seife/marble_fx/doc/README.md

# How I modified my MarbleFX
I used a CJMCU Beetle board, because the integrated USB plug makes it very easy to solder the USB cable due to the large pin spacing.

## This is the MarbleFX before modification:
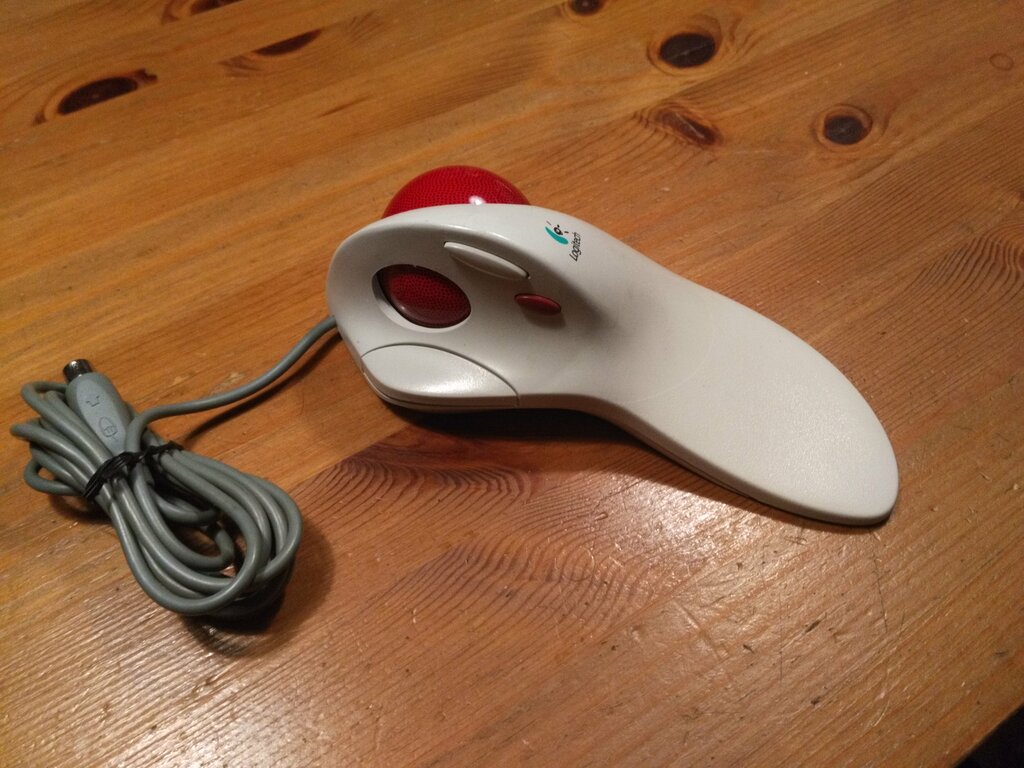
[picture p1: doc/01-marble_fx-original.jpg]
The unmodified MarbleFX


## The bottom opened and the interface PCB removed:
(beware, there's a screw hidden below the label sticker)
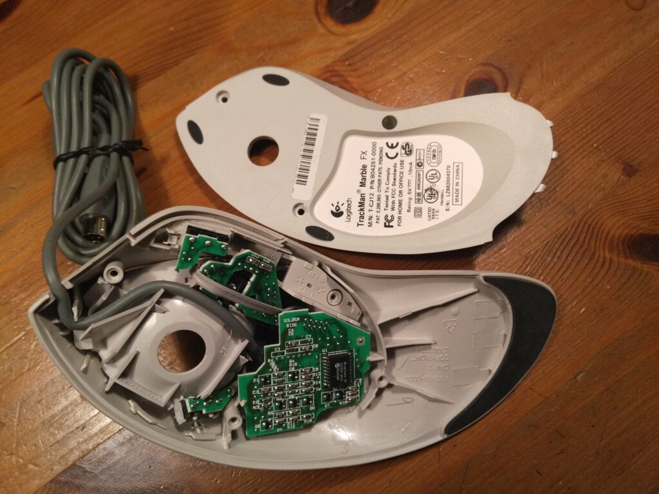
[picture p2: doc/02-marble_fx-open1.jpg]
Bottom opened

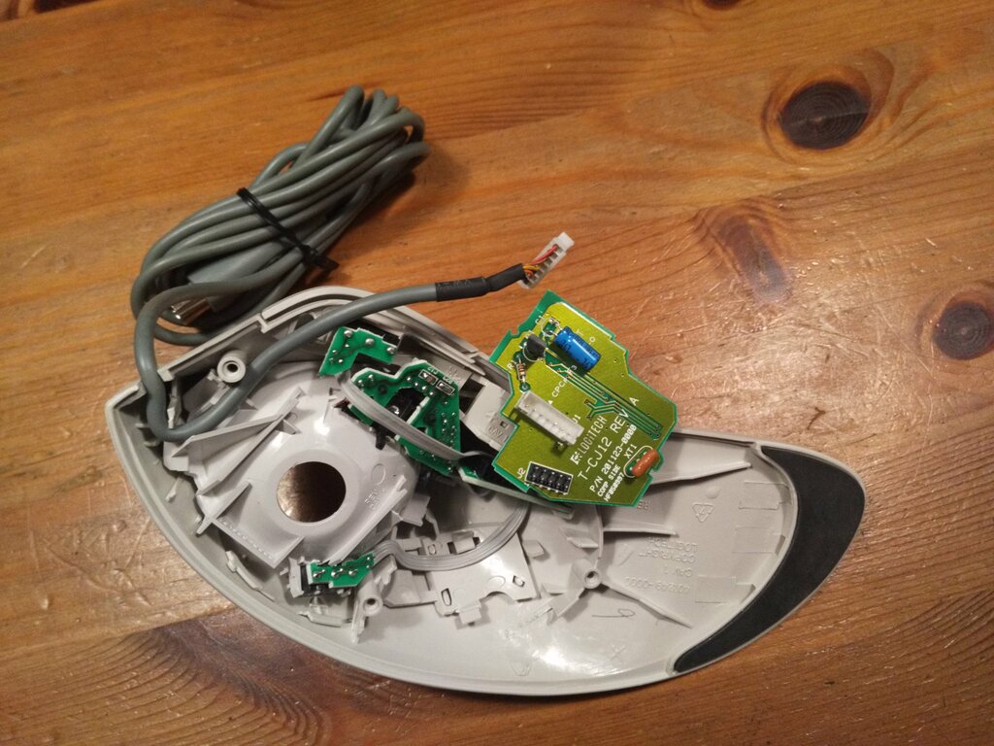
[picture p3: doc/03-marble_fx-open2.jpg]
PCB removed


## Close ups of the removed daughter PCB
(you need to solder the pins from the leonardo board to this board)
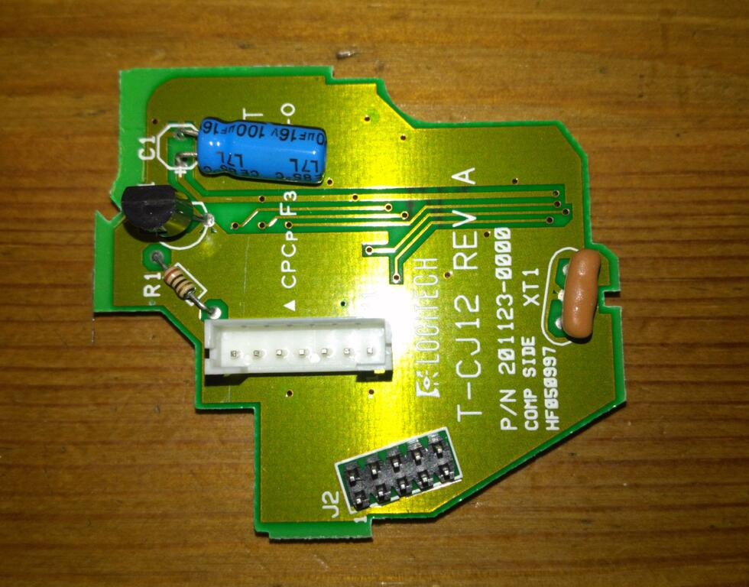
[picture p4: doc/04-marble_fx-pcb1.jpg]
PCB closeup 1

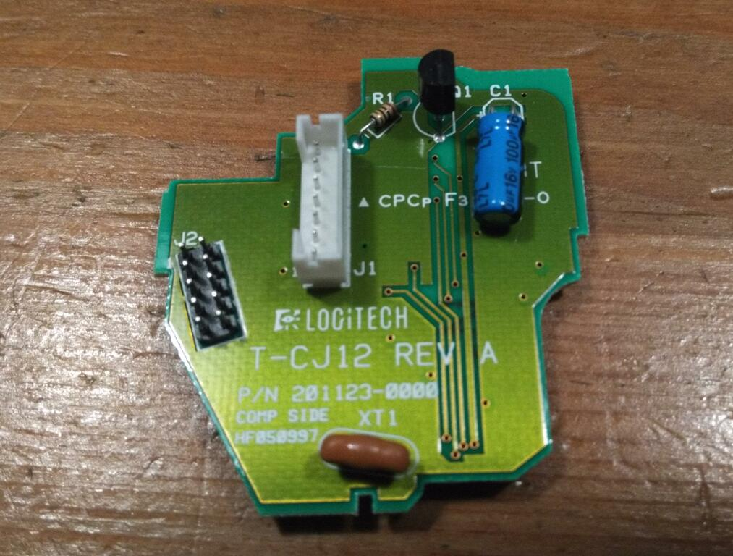
[picture p5: doc/05-marble_fx-pcb2.jpg]
PCB closeup 2


## Soldered the cables (USB and to the MarbleFX PCB) to the beetle
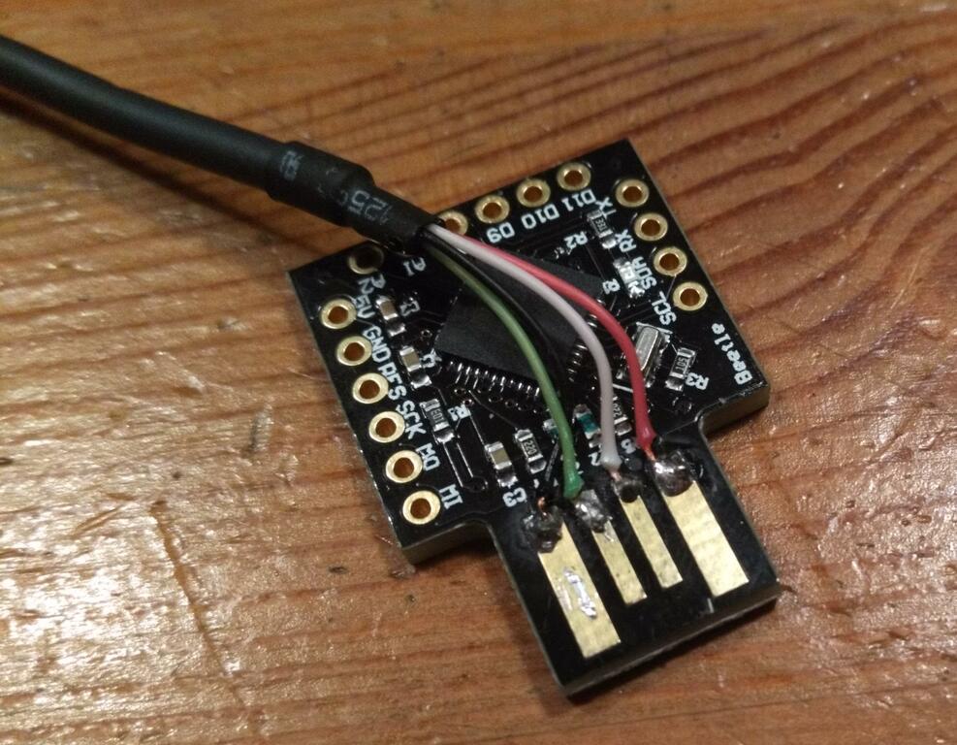
[picture p6: doc/06-marble_fx-beetle1.jpg]
Beetle USB cable

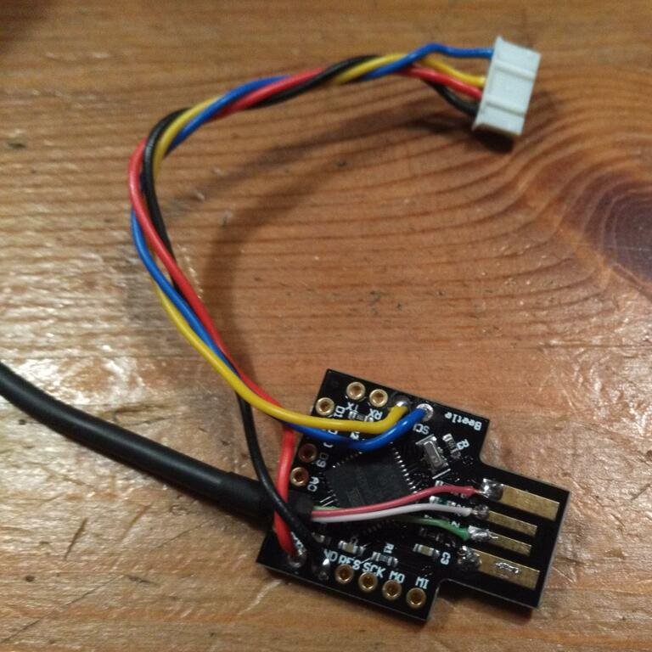
[picture p7: doc/07-marble_fx-beetle2.jpg]
Beetle USB+PCB cable


## Now connect it to the daughter PCB
I used a connector from a Logitech USB mouse cable, so that I did not need to cut the original PS/2 cable. So everything can be returned to the original state.
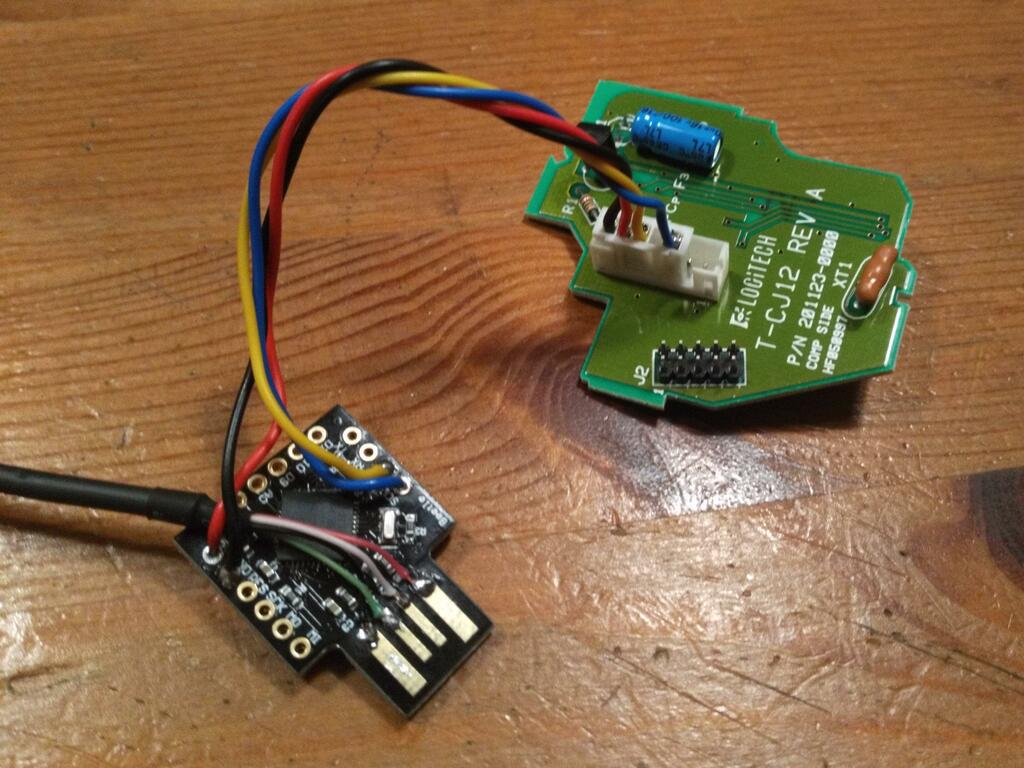
[picture p8: doc/08-marble_fx-beetle-pcb1.jpg]
Beetle + PCB1

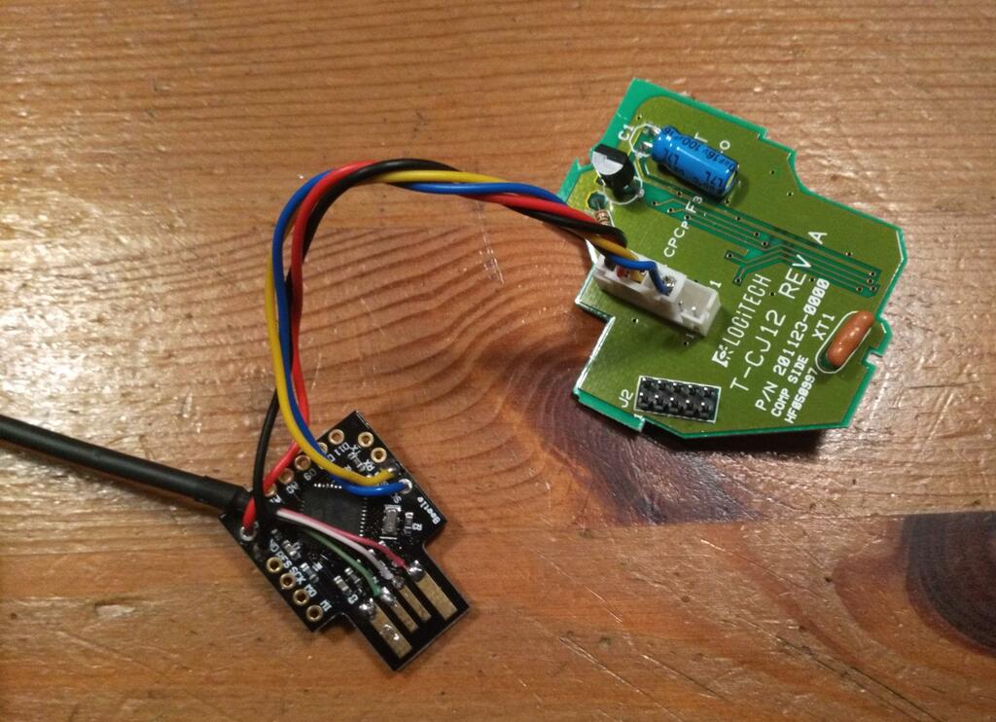
[picture p9: doc/09-marble_fx-beetle-pcb2.jpg]
Beetle + PCB2


## This is how the Beetle board fits into the MarbleFX
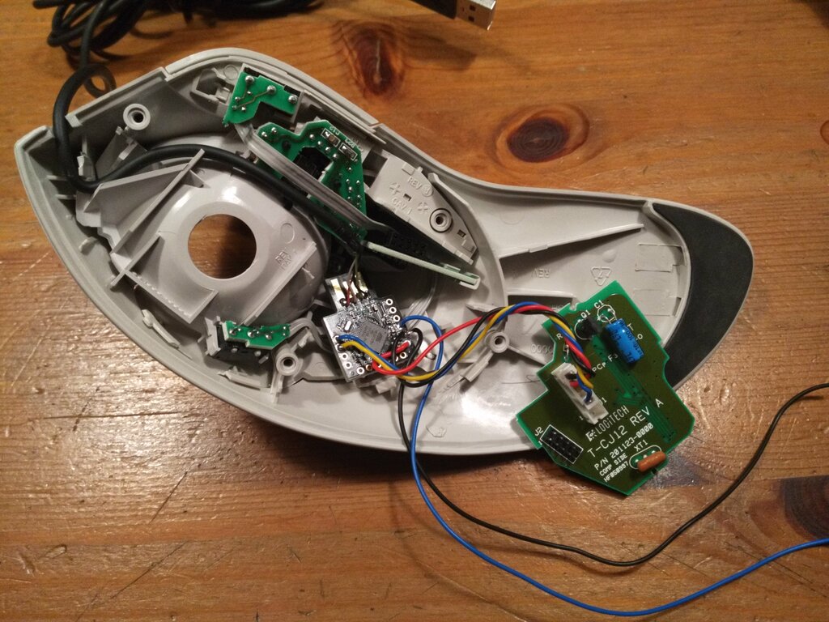
[picture p10: doc/10-marble_fx-beetle-mounted.jpg]
Mounted

The Beetle is kept in place by the daughter board.

The additional blue and black cables are RESET and GND, stored below the bottom plate, so that reflashing is easier by triggering a board reset, even if the ACM interface has been patched out of the USB core.
