seife/marble_fx/(threads)

Thread 1 (2024-04-05):

2D scrolling

sobukus, 2024-04-05:
I was able to test the code now on a 32u4 Arduino Pro Micro with the T-CJ12. It seems to need a reinsertion when combined with usbguard after allow-device (maybe some hook to re-init hardware when the kernel driver is allowed to work is needed, normal devices work right away after lifting the software  block).

But to come to the issue: I see that the red button is directly translated to scroll events in the Arduino. This spares any extra software setup on the PC, but it prevents the full experience: two-dimensional scrolling in both axes! How can you live without? ;-)

```
       DSERIAL(print("SCRL "));
        DSERIAL(println((int)scroll));
```

Is there an equivalent command to handle scrolling in x direction at the  same time? Or is the only solution to just pass through the red button and use xinput to configure things? Maybe we can use some idle pins to provide a switch for hardware of software scrolling mode?

(Also: A custom device string would be nice if software scrolling needs to be configured …)

sobukus, 2024-04-05:
Wait … there is only `MOUSE_LEFT`, `MOUSE_RIGHT` and `MOUSE_MIDDLE` available for https://www.arduino.cc/reference/en/language/functions/usb/mouse/mousepress/ ?! That is rather limiting. The HID protocol allows for a larger number of buttons, I presume.

sobukus, 2024-04-05:
See pull request #2.

seife, 2024-07-03:
I actually wanted to implement 2d scrolling (and "hires scrolling" with smaller steps), but these extended HID things are rather complicated unfortunately, so I did not yet start with that.

PR #2 is merged, so this can be made to work with Linux now, but long term I'd like to have a platform agnostig solution in the converter code, which should work on all OSes without additional configuration.

If you happen to beat me to implementing this, that would of course be very welcome ;-)
