seife/marble_fx/marble_fx.ino

/*
 * Logitech TrackMan Marble FX wheel driver
 * also supports Logitech TrackMan Marble model T-BC21 (in ps/2 mode)
 *
 * Copyright © 2018-2026 Stefan Seyfried <seife@tuxbox-git.slipkontur.de>
 *
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
 *  tested on: paradisetronic Pro Micro (mini leonardo-compatible board)
 *             CMCU beetle (nano USB-connector-only leonardo-compatible)
 *             Arduino Leonardo, probably a cheap clone board
 *
 *  PS2++ protocol specs from http://web.archive.org/web/20030714000535/http://dqcs.com/logitech/ps2ppspec.htm
 *
 * based on this:
 *   Arduino Forum > Topics > Device Hacking > Logitech TrackMan Marble FX USB converter
 *   https://forum.arduino.cc/index.php?topic=365472.0
 *
 * SAMPLE_RATE and stream_mode setting idea from
 *   https://github.com/dkao/Logitech_Trackman_Marble_FX_PS2_to_USB_converter
 *
 * interrupt routines inspired by the qmk firmware:
 *   https://github.com/qmk/qmk_firmware
 *
 * depends on these libraries:
 *   HID-Project  (https://github.com/NicoHood/HID, install via library manager)
 *   Arduino-GPIO (https://github.com/mikaelpatel/Arduino-GPIO, install from source)
 *
 * The T-BC21 trackball has four buttons. It has an USB cable, but can also speak PS/2
 * We use the PS/2 mode
 *
 *  default HW setup
 *   wire PS/2 connector to arduino PIN 2 (data) and 3 (clk)
 *   wire switch to gnd on PIN 6 to enable red button reported as button 8
 *     (disabled internal scrolling, enable 2D software wheel emulation)
 *   see: http://playground.arduino.cc/ComponentLib/Ps2mouse
 *   for the T-BC21, wire USB D- (next to VBUS) is data and USB D+ (next to GND) is clk
 *
 *  driver limitations:
 *   use at your own risk.
 *   super hack. tested on my own TrackMan Marble FX(T-CJ12) only
 *               now also tested on TrackMan Marble (model T-BC21)
 *
 *  functionality:
 *   Marble FX: press red button to emulate wheel movement with the ball
 *   T-BC21: left small button is "red button", scroll wheel emulation,
 *           right small button is "middle button" (button 3)
 */

//# define SERIALDEBUG 1
//# define LED_DEBUG
#define MY_HIDMOUSE 1

#ifdef MY_HIDMOUSE
#include "HIDMouse.h"
#elif defined(USE_LEGACY_HID)
#include "Mouse.h"
#else
#include "HID-Project.h"
#endif
#include "GPIO.h"

#include <avr/wdt.h>
/*
 * Pin definitions
 */
#define DATA_PIN 2
#define CLK_PIN  3
/* configuration input switches */
#define LEFTHAND_PIN 8
#define JIGGLE_PIN   7
#define SCROLL_PIN   6

/* int2board(CLK_PIN) == BOARD::D3 */
#define B_CONCAT(x) BOARD::D##x
#define int2board(x) B_CONCAT(x)

GPIO<int2board(DATA_PIN)>     pin_DATA;
GPIO<int2board(CLK_PIN)>      pin_CLK;
GPIO<int2board(LEFTHAND_PIN)> pin_LEFTHAND;
GPIO<int2board(JIGGLE_PIN)>   pin_JIGGLE;
GPIO<int2board(SCROLL_PIN)>   pin_SCROLL;
GPIO<int2board(LED_BUILTIN)>  pin_LED;

#ifdef LED_DEBUG
#define LED1_PIN 10
#define LED2_PIN 11
GPIO<int2board(LED1_PIN)> pin_LED1;
GPIO<int2board(LED2_PIN)> pin_LED2;
#define DBG(PIN, FUNC) do { PIN.FUNC; } while (0)
#else
#define DBG(PIN, FUNC) do {} while (0)
#endif

#ifdef SERIALDEBUG
/* "if (Serial) { ... }" does not work as this includes a "delay(10)" call m( */
#define DSERIAL(WHAT) do {if (Serial.availableForWrite()){ Serial.WHAT; }} while(0)
#else
#define DSERIAL(WHAT)
#endif

#define pin_high(PIN) do { PIN.input().pullup(); } while (0)
#define pin_low(PIN)  do { PIN.output(); PIN.low(); } while (0)
#define pin_set(PIN, STATE) do { if (STATE) pin_high(PIN); else pin_low(PIN); } while (0)

/* defines for magic protocol bytes
 * https://web.archive.org/web/20051201201655/http://www.computer-engineering.org/ps2mouse/ */
#define PS2_RESET      0xFF
#define PS2_REPORT_DIS 0xF5
#define PS2_REPORT_ENA 0xF4
#define PS2_SET_SRATE  0xF3
#define PS2_SET_REMOTE 0xF0
#define PS2_READ_DATA  0xEB
#define PS2_SET_STREAM 0xEA
#define PS2_STATUS     0xE9
#define PS2_SET_RESO   0xE8

/* non-standard SAMPLE_RATE setting is disabled by default.
 * while it sounds useful at first glance, it results in problems when
 * (really) fast moving the ball, and it does not give considerable
 * benefits in standard usage etiher
 * you can uncomment this define to use it if you want
 *
 * Set sample rate.
 * PS/2 default sample rate is 100Hz.
 * Valid sample rates: 10, 20, 40, 60, 80, 100, 200
 */
//#define SAMPLE_RATE 200

#define JIGTIMEOUT 30000
class MyTimer
{
public:
  MyTimer() { start_time = 0; count = 0; enabled = true; };

  void reset(void) { start_time = millis(); count = 0; };
  void expire(void) { count = 66; };
  bool expired(void) { return count > 60; };
  bool action(void) {
    if (! enabled || expired())
      return false;
    unsigned long now = millis();
    if (now - start_time < JIGTIMEOUT)
      return false;
    while (now - start_time >= JIGTIMEOUT) {
      count++;
      start_time += JIGTIMEOUT;
    }
    return ! expired();
  };
  int count;
  bool enabled;
private:
  unsigned long start_time;
};

MyTimer jiggletimer;
MyTimer heartbeat;

class JigglerLed
{
public:
  JigglerLed() { last_time = millis(); on = false; };

  void action(bool enabled) {
    if (! enabled) {
      DSERIAL(println("JigglerLed: not enabled"));
      if (!on)
        pin_LED.high();
      on = true;
      return;
    }
    unsigned long now = millis();
    unsigned long diff = now - last_time;
    if (on) {
      if (diff < 100)
        return;
      last_time += 100;
      pin_LED.low();
      on = false;
      DSERIAL(print("JigglerLed: short tick "));
    } else {
      if (diff < 1900)
        return;
#ifdef MY_HIDMOUSE
      DSERIAL(println("GET/SET " + String(Mouse.getReportCalled) + "/" +
                      String(Mouse.setReportCalled)+" # "+String(Mouse.setReportVal)));
#endif
      last_time += 1900;
      pin_LED.high();
      on = true;
      DSERIAL(print("JigglerLed: long  tick "));
    }
    DSERIAL(print(now));
    DSERIAL(print(" "));
    DSERIAL(println(diff));
  };
private:
  bool on;
  unsigned long last_time;
};

JigglerLed JLed;

/* will be set from switches on pins 7 and 8 */
bool lefthanded = false;
/* global variables */
uint8_t xtrabutton = 0;
bool buttons[4] = { false, false, false, false };
// lucky us, the definitions of MOUSE_LEFT,_RIGHT,_MIDDLE are also 1,2,4...
// Red button is mappend to the 8th one, matching PS/2.
// Values are not straightforward ... button 8 is not 8th bit,
// but fourth bit (value 8).
uint8_t bimask[4] = { 0x01, 0x02, 0x04, 0x10 };
uint8_t bomask[4] = { 0x01, 0x02, 0x04, 0x08 };
int8_t scroll_sum = 0;

bool stream_mode = true;
bool internal_scrolling = true; // handle scroll button internally

const uint8_t clk_interrupt = digitalPinToInterrupt(3);
uint8_t ps2_error = 0;

class Mousebuffer
{
  /* ring buffer for received bytes */
  #define MBUF_SIZE 16
private:
  uint8_t buf[MBUF_SIZE];
  uint8_t head;
  uint8_t tail;
public:
  Mousebuffer(void) { head = tail = 0; };
  void push(uint8_t data) {
    uint8_t sreg = SREG;
    cli();
    uint8_t next = (head + 1) % MBUF_SIZE;
    if (next != tail) {
      buf[head] = data;
      head = next;
    }
    SREG = sreg;
  };
  uint8_t pull(void) {
    uint8_t ret = 0;
    uint8_t sreg = SREG;
    cli();
    if (head != tail) {
      ret = buf[tail++];
      tail %= MBUF_SIZE;
    }
    SREG = sreg;
    return ret;
  };
  bool empty(void) {
    uint8_t sreg = SREG;
    cli();
    bool ret = (head == tail);
    SREG = sreg;
    return ret;
  };
  void reset(void) {
    uint8_t sreg = SREG;
    cli();
    head = tail = 0;
    SREG = sreg;
  };
};
Mousebuffer mbuf;

enum {
  NONE, START,
  BIT0, BIT1, BIT2, BIT3, BIT4, BIT5, BIT6, BIT7,
  PARITY, STOP
};

void ps2_ISR(void)
{
  static uint8_t bit = NONE;
  static uint8_t data = 0;
  static bool parity = false;

  if (pin_CLK) /* ???, we trigger on FALLING */
    return;

  bit++;
  switch (bit) {
    case START:
      if (pin_DATA)
        goto error;
      break;
    case BIT0...BIT7:
      data >>= 1;
      if (pin_DATA) {
        data |= 0x80;
        parity = parity ^ 1;
      }
      break;
    case PARITY:
      if (pin_DATA == parity)
        goto error;
      break;
    case STOP:
      if (!pin_DATA)
        goto error;
      mbuf.push(data);
      DBG(pin_LED1, low());
      goto done;
      break;
    default:
      goto error;
  }
  return;
error:
  ps2_error = bit;
  DBG(pin_LED1, high());
done:
  bit = NONE;
  data = 0;
  parity = false;
  return;
}

void bus_idle(void)
{
  pin_high(pin_DATA);
  pin_high(pin_CLK);
}

void bus_stop(void)
{
  pin_low(pin_CLK);
  pin_high(pin_DATA);
}

class Timeout
{
public:
  Timeout() {};
  void reset() { start = millis(); };
  bool elapsed() { return (millis() - start) > 500; };
private:
  unsigned long start;
};
Timeout SendTimeout;

#define loop_while(COND) \
  while (COND) { \
    if (SendTimeout.elapsed()) \
      goto error; \
  }

#define send_bit(LEVEL) \
  do { \
    pin_set(pin_DATA, LEVEL); \
    loop_while(!pin_CLK); \
    loop_while(pin_CLK); \
  } while (0)

void mouse_write(uint8_t data)
{
  uint8_t i;
  uint8_t parity = 1;
  SendTimeout.reset();

  detachInterrupt(clk_interrupt);
  /* put pins in output mode */
  bus_idle();
  delayMicroseconds(300);
  pin_low(pin_CLK);
  delayMicroseconds(300);
  pin_low(pin_DATA);
  delayMicroseconds(10);
  DBG(pin_LED1, high());
  /* start bit */
  pin_high(pin_CLK);
  delayMicroseconds(10); /* Arduino-GPIO is too fast, so wait until CLK is actually high */
  /* wait for mouse to take control of clock); */
  loop_while(pin_CLK);
  /* clock is low, and we are clear to send data */
  for (i=0; i < 8; i++) {
    send_bit(data & 1);
    parity = parity ^ (data & 0x01);
    data >>= 1;
  }
  /* parity */
  send_bit(parity);
  /* stop bit */
  pin_high(pin_DATA);
  delayMicroseconds(50);
  loop_while(pin_CLK);
  /* wait for mouse to switch modes */
  loop_while(! pin_CLK || ! pin_DATA);
  DBG(pin_LED1, low());
  bus_idle();             /* enable incoming data, will be handled by ISR */
  delayMicroseconds(10);  /* to allow pin_CLK to settle */
  attachInterrupt(clk_interrupt, ps2_ISR, FALLING);
  return;
error:
  /* error recovery code in loop() will try to restart ps2 mouse */
  bus_stop();
  ps2_error = 0x10;
}

/*
 * check ringbuffer state
 * wait for max ~200ms for byte to arrive, then return
 * normally, this should not take longer than 20ms, but the logitechs seem
 * to take longer... And it should not hurt as it is only a worst-case value.
 */
bool mouse_ready(void)
{
  uint8_t retry = 200;
  while (retry-- && mbuf.empty())
    delay(1);
  bool ret = !mbuf.empty();
  DBG(pin_LED2, write(ret));
  return ret;
}

/* convenience function: fetch a byte with wait */
uint8_t mouse_read()
{
  if (mouse_ready())
    return mbuf.pull();
  return 0;
}

void mouse_init()
{
  bus_idle();
  delay(250);    /* allow mouse to power on */
  /* reset */
  mouse_write(PS2_RESET);
  mouse_read();  /* ack */
  delay(400);    /* the reset takes almost 400ms */
  mouse_read();  /* 0xAA */
  mouse_read();  /* Device ID 0x00 */
#ifdef SAMPLE_RATE
  mouse_write(PS2_SET_SRATE);
  mouse_read();  /* ack */
  mouse_write(SAMPLE_RATE);
  mouse_read();  /* ack */
#endif
  if (!stream_mode) {
    mouse_write(PS2_SET_REMOTE);
    mouse_read();  /* ack */
    delayMicroseconds(100);
  }
}

void mouse_enable_report()
{
  mouse_write(PS2_REPORT_ENA);
  mouse_read(); /* ack */
  delayMicroseconds(100);
}

// PS2++, extended ps/2 protocol spec.
// http://web.archive.org/web/20030714000535/http://dqcs.com/logitech/ps2ppspec.htm
// also, linux kernel ps2 mouse drivers have extensive code to look up the protocol.
static uint8_t magic[] = { 0xe8, 0x00, 0xe8, 0x03, 0xe8, 0x02, 0xe8, 0x01, 0xe6, 0xe8, 0x03, 0xe8, 0x01, 0xe8, 0x02, 0xe8, 0x03 };
void ps2pp_write_magic_ping()
{
  /* e8 00 e8 03 e8 02 e8 01 e6 e8 03 e8 01 e8 02 e8 03 */
  for (uint8_t i = 0; i < sizeof(magic); i++)
    mouse_write(magic[i]);
}

void mouse_setup(void)
{
  mouse_init();
  ps2pp_write_magic_ping();
  if (stream_mode)
    mouse_enable_report();
  /* mouse will return a ps2++ P0 packet, which loop() will handle */
}

bool ps2pp_decode(uint8_t b0, uint8_t b1, uint8_t b2)
{
#ifdef SERIALDEBUG
  if ((b0 & 0x48) == 0x48) {
    uint8_t ptype = ((b0 & 0x30) >> 2) | ((b1 & 0x30) >> 4);
    DSERIAL(print("ps2++ packet type P"));
    DSERIAL(print(ptype, HEX));
    switch (ptype) {
      case 0xb:
        {
          if (b2 & 0x80)
            DSERIAL(print(" BTN: 0x"));
          else
            DSERIAL(print(" SHP: 0x"));
          DSERIAL(print(b2 & 0x7f, HEX));
        }
    }
    DSERIAL(print(" (raw: 0x"));
    DSERIAL(print(b0, HEX));
    DSERIAL(print(" 0x"));
    DSERIAL(print(b1, HEX));
    DSERIAL(print(" 0x"));
    DSERIAL(print(b2, HEX));
    DSERIAL(println(")"));
  }
#endif
  /* values from linux/drivers/input/mouse/logips2pp.c */
  if ((b0 & 0x48) != 0x48 || (b1 & 0x02) != 0x02)
    return false;
  // mouse extra info
  if ((b0 & 0x30) == 0x0 && (b1 & 0xf0) == 0xd0) {
    xtrabutton = (b2 & 0x30);
    DSERIAL(print("xtrabutton: "));
    DSERIAL(println((int)xtrabutton, HEX));
  }
  return true;
}

/* the main() program code */
void setup()
{
  Mouse.begin(); /* does not actually "begin" anything but defines USB descriptors */
  pin_low(pin_DATA);
  pin_low(pin_CLK);
  pin_SCROLL.input().pullup();
  pin_JIGGLE.input().pullup();
  pin_LEFTHAND.input().pullup();
  internal_scrolling = pin_SCROLL;
  jiggletimer.enabled = pin_JIGGLE; /* default on if pin open */
  lefthanded = !pin_LEFTHAND; /* default off */
#ifdef SERIALDEBUG
  Serial.begin(115200); /* baudrate does not matter */
  delay(100);
  while(! Serial) {
    if (millis() > 10000)
      break; /* continue anyway... */
  }
  DSERIAL(println("HELLO!"));
  DSERIAL(print("Jiggler:\t"));
  DSERIAL(println(jiggletimer.enabled));
  DSERIAL(print("Lefthanded:\t"));
  DSERIAL(println(lefthanded));
#endif
  pin_LED.output();
  pin_LED.high();
  DBG(pin_LED1, output());
  DBG(pin_LED2, output());
  DBG(pin_LED1, low());
  DBG(pin_LED2, low());
  mouse_setup();
#ifdef MY_HIDMOUSE
  DSERIAL(println("GET/SET " + String(Mouse.getReportCalled) + "/" +
                  String(Mouse.setReportCalled)+" # "+String(Mouse.setReportVal)));
#endif
}

#ifdef NO_SCALE
int8_t scale(int8_t v)
{
  return v;
}

int8_t scrollscale(int8_t v)
{
  return v;
}
#else
int8_t scale(int8_t v)
{
  /* with sample_rate=200 max values for x and y are ~20
   * with sample_rate=100, it's about double that => ~40
   * above is true with T-CJ12,
   * with T-BC21 it sems that ~25 is max at rate = 200
   * a T-CM14 (2 buttons only) gives ~20 like T-CJ12 */
  int a = abs(v);
  int8_t ret;
  if (a > 128/3) {  /* just don't overflow */
    if (v > 0)
      return 127;
    return -127;
  }
  switch(a) {
#if SAMPLE_RATE == 200
    case 10 ... 128:/* 10 => 30 */
      return v * 3;
    case 9:   ret = 25; break;
    case 8:   ret = 19; break;
    case 7:   ret = 14; break;
    case 6:   ret = 10; break;
    case 5:   ret = 7;  break;
    case 4:   ret = 5;  break;
#else
    case 20 ... 128:
      return v * 3;
    case 19:  ret = 55; break;
    case 18:  ret = 50; break;
    case 17:  ret = 44; break;
    case 16:  ret = 38; break;
    case 15:  ret = 33; break;
    case 14:  ret = 28; break;
    case 13:  ret = 24; break;
    case 12:  ret = 20; break;
    case 11:  ret = 17; break;
    case 10:  ret = 14; break;
    case  9:  ret = 12; break;
    case  8:  ret = 10; break;
#endif
    default:  return v;
  }
  if (v < 0)
    return -ret;
  return ret;
}

/* acceleration for the scroll wheel emulation. Now that we are using high
 * resolution scrolling, this actually makes sense. */
int8_t scrollscale(int8_t v)
{
  int a = abs(v);
  int8_t ret;
  if (a > 120/3) {  /* see the above scale() comment -- unlikely to get a>50 at all */
    if (v > 0)      /* so this is just for paranoia */
      return 120;
    return -120;
  }
  switch(a) {
    case 20 ... 128:
      ret = 120; break;
    case  4 ... 8:
      ret = a * 3; break;
    case 9 ... 15:
      ret = a * 4; break;
    case 16 ... 19:
      ret = a = 5; break;
    default:  return v;
  }
  if (v < 0)
    return -ret;
  return ret;
}
#endif

void move(int8_t x, int8_t y, int8_t v, int8_t h = 0)
{
#ifdef MY_HIDMOUSE
  Mouse.move(scale(x), scale(y), scrollscale(v), scrollscale(h));
#else
  Mouse.move(scale(x), scale(y), v);
  (void)h;
#endif
  jiggletimer.reset();
}

/*
 * mstat bit 0 = 0x01 left;
 * mstat bit 1 = 0x02 right;
 * xtra  bit 4 = 0x10 small left on Marble T-BC21, red button on Marble FX;
 * xtra  bit 5 = 0x20 small right on Marble T-BC21;
 * red button will be scroll, 0x20 will be mapped to 0x04 => middle button
 * return value: bit 0,1,2 = left, right, middle, bit 4 = scroll
 * if lefthanded == true, then buttons will be swapped (only useful with T-BC21)
 */
uint8_t map_buttons(uint8_t mstat, uint8_t xtra)
{
  uint8_t ret = 0;
  if (! lefthanded) {
    ret = mstat & 0x07; /* standard left/right/middle buttons */
    if (xtra & 0x20)
      ret |= 0x04;
    if (xtra & 0x10)
      ret |= 0x10; /* scroll button */
  } else { /* invert */
    if (mstat & 0x01)
      ret = 0x02;
    if (mstat & 0x02)
      ret |= 0x01;
    if (xtra & 0x10)
      ret |= 0x04;
    if (xtra & 0x20)
      ret |= 0x10; /* scroll button */
  }
  return ret;
}

void loop()
{
#ifdef SERIALDEBUG
  if (Serial.available())
    Serial.read(); /* avoid host side blocking if something is typed in terminal */
#endif
  /* update the switch state.
     Does this even make sense at run time? but it does not hurt anyway ;-)
     Yes: User expects switches to match current behaviour without a
     'reboot' of the mouse device. */
  internal_scrolling = pin_SCROLL;
  jiggletimer.enabled = pin_JIGGLE; /* default on if pin open */
  lefthanded = !pin_LEFTHAND; /* default off */
  JLed.action(jiggletimer.enabled && !jiggletimer.expired());
  if (ps2_error) {
    DSERIAL(println("PS2_ERROR => Reset"));
    detachInterrupt(clk_interrupt);
    bus_stop();
    ps2_error = 0;
    mbuf.reset();
    mouse_setup();
  }
  if (!stream_mode) {
    mouse_write(PS2_READ_DATA);
    mouse_read();      /* ignore ack */
  }
  else if (heartbeat.action()) {
    DSERIAL(print("HEARTBEAT:"));
    heartbeat.reset();
    mouse_write(PS2_STATUS); /* status request */
    for (uint8_t i = 0; i < 4; i++) { /* ack + 3 byte response */
      DSERIAL(print(" 0x"));
      uint8_t d = mouse_read();
      DSERIAL(print(d, HEX));
      (void)d;
    }
    DSERIAL(println());
  }
  bool ret = mouse_ready();
  if (ret) { /* no timeout */
    uint8_t mstat = mbuf.pull();
    int8_t mx    = (int8_t)mouse_read();
    int8_t my    = (int8_t)mouse_read();
    DSERIAL(print(mstat, HEX));
    DSERIAL(print("\t"));
    DSERIAL(print((int)mx));
    DSERIAL(print("\t"));
    DSERIAL(println((int)my));
    if (ps2pp_decode(mstat, mx, my) || USBDevice.isSuspended())
      return; // do nothing.

    if (mstat & 0xC0) { /* the overflow bits are never set on ps2pp */
      ps2_error = mstat;
      DSERIAL(println("OVERFLOW"));
      return; /* will reenter loop() and reset from there */
    }

    uint8_t btn = map_buttons(mstat, xtrabutton);
    bool redbutton = btn & bimask[3];
    if (internal_scrolling && redbutton) { /* translate y scroll into wheel-scroll */
#ifdef MY_HIDMOUSE
      int8_t scroll = my;
      int8_t hscroll = mx;
#else
      int8_t scroll = my / 8;
      int8_t hscroll = 0;
      if (! scroll) {
        scroll_sum += my;
        scroll = scroll_sum / 8;
        if (scroll != 0)
          scroll_sum = 0;
      }
#endif
      if (hscroll != 0 || scroll != 0) {
        DSERIAL(print("SCRL "));
        DSERIAL(print((int)scroll));
        DSERIAL(print(" "));
        DSERIAL(println((int)hscroll));
        if (abs(hscroll) > abs(scroll))
          scroll = 0;
        else
          hscroll = 0;
        move(0, 0, scroll, hscroll);
      }
    } else {
      /* -my to get the direction right... */
      if (mx != 0 || my != 0) {
        move(mx, -my, 0);
        DSERIAL(print("MOVE "));
        DSERIAL(print((int)mx));
        DSERIAL(print(" "));
        DSERIAL(print((int)my));
        static int max_x, max_y;
        if (abs(mx) > max_x)
          max_x = abs(mx);
        if (abs(my) > max_y)
          max_y = abs(my);
        DSERIAL(print(" "));
        DSERIAL(print((int)max_x));
        DSERIAL(print(" "));
        DSERIAL(print((int)max_y));
        DSERIAL(println());
      }
      scroll_sum = 0;
    }

    /* handle normal buttons */
    for (uint8_t i = 0; i < sizeof(buttons); i++) {
      if (internal_scrolling && i == 3)
        continue;
      bool button = btn & bimask[i];
      if (redbutton && i == 2 && button && buttons[i] != button) {
        jiggletimer.expire();
        continue;
      }
      if (!buttons[i] && button)
        Mouse.press(bomask[i]);
      else if (buttons[i] && !button)
        Mouse.release(bomask[i]);
      buttons[i] = button;
    }

    if (!stream_mode)
      delay(20);
  }

  if (jiggletimer.action()) {
    if (!USBDevice.isSuspended()) {
      DSERIAL(print("JIGGLE! "));
      DSERIAL(println(jiggletimer.count));
      Mouse.move(1,0,0);
      Mouse.move(-1,0,0);
    }
  }
}
