seife/marble_fx/(commit log)

2018-12-11 do not send non-moving Mouse.move()
    The steady stream of Mouse.move(0,0,0) prevents screen savers and
    probably causes hosts not to sleep, so avoid it.
    [marble_fx.ino]
2020-10-20 avoid "char", use "(u)int8_t" instead
    This clarifies the signedness of the types
    [marble_fx.ino]
2020-11-16 debounce buttons
    my Trackman Marble FX has a "nervous" right button. Just debounce it in
    software :-)
2021-01-11 add Makefile for easy building with arduino-mk
    This also overrides USB power consumption descriptor to 50mA and sets
    the USB description to something nicer :-)
2021-09-08 set sample rate to 200Hz
    idea from
    https://github.com/dkao/Logitech_Trackman_Marble_FX_PS2_to_USB_converter
2021-09-08 simplify loop() by early bailing out
    note that this in theory might kill the mouse jiggler when one of the
    extra buttons is kept pressed, but that's not a practical concern
2021-09-08 remove software button debounce
    this reverts 84658ef06784e7f5609769f975da7a6b45cbf63d
    rather have a new switch soldered instead of slowing down clicks ;-)
    [marble_fx.ino]
2021-09-08 Add support for T-BC21 Trackman Marble
    This is a symmetrical 4-button trackball. Both extra buttons are
    reported via logitech mode, no "real" middle button (button 3).
    Add a global variable to allow the T-BC21 to be used in left-handed
    modes (mirrored buttons). Small thumb button is scroll emulation,
    the other small button is button 3.
2021-09-11 improve debugging
    with SERIALDEBUG, wait for serial connection before starting
    invert LED_BUILTIN with every loop to show if the sketch is hanging:
    as long as it's running fine, the LED will blink with ~0.5Hz (in
    STREAM_MODE)
    [marble_fx.ino]
2021-09-11 add sleep to allow mouse to start after power on
2021-09-11 Allow run-time config of jiggler and lefthand mode
    two dip switches connected to pins 7 and 8 and ground allow to change
    the defaults
2021-09-13 add compile and upload scripts using arduino-cli
2021-09-17 disable STREAM_MODE and 200Hz SAMPLE_RATE again
    it looked useful, but for me brings more problems than benefits, so
    let's disable it as default
    [marble_fx.ino]
2023-02-19 use NicoHood's HID-Project by default
    NicoHood's HID-Project seems to be better at initializing the devices on
    Windows hosts after resume, so use that by default. By setting cpp flag
    "-DUSE_LEGACY_HID" you can still revert to use the legacy Mouse.h
    [marble_fx.ino]
2023-02-23 indent the #ifdef STREAM_MODE case
    whitespace-only change, to prepare replacing the #ifdef with a
    runtime controllable variable without too much whitespace changes
    [marble_fx.ino]
2023-02-23 add timeout to ps/2 mouse communication
    This hopefully allows to rescue "out of sync" situations.
    In non-STREAM_MODE case the board is reset to get it going again.
    [marble_fx.ino]
2023-02-23 use the Arduino-GPIO library for fast pin access
    install from https://github.com/mikaelpatel/Arduino-GPIO
    This seems to make mouse communication much more reliable.
2023-02-24 add debug via two additional LEDs
    enable with #define LED_DEBUG
2023-02-24 fix type of millis() storage variables
    [marble_fx.ino]
2023-02-24 factor out mouse_setup() function
    ...so that it can be reused later for error handling
    [marble_fx.ino]
2023-02-24 add interrupt-driven mouse read function
    This is much more elegant than busy-looping and additionally also adds
    better sanity checking (parity, start, stop bits not ignored).
    This should also allow for easier recovery in case the mouse gets out of
    sync.
2023-02-25 remove non-interrupt code
    Now that I managed to make it work ;-), interrupt mode is clearly the
    way to go. Remove the old blocking-IO version of mouse_read() and other
    legacy artefacts.
2023-02-25 put the jiggle timer stuff into a C++ class
2023-02-25 fix return code check for remote mode
    even in non-stream mode, we now need to check for the "timeout" after
    trying to fetch data from the mouse.
    [marble_fx.ino]
2023-02-25 first try at ps2 protocol error recovery
    [marble_fx.ino]
2023-02-25 Mousebuffer: fix sequence-point warning
    [marble_fx.ino]
2023-02-26 rework mouse_read() function
    split into "bool mouse_ready()" which waits for at least one byte in the
    ringbuffer and "char mouse_read()" which waits for ready and then pulls
    a byte from the buffer. This simplifies the "wait with timeout for a
    byte from the mouse" code.
    [marble_fx.ino]
2023-02-26 add debugging to ps2pp_decode
    print out the ps2++ packet types and for PB additional decoded info
2023-02-26 reset ps2 interface on invalid data
    This recovers e.g. from mouse unplug / replug.
    [marble_fx.ino]
2023-02-26 better ps2 error recovery
    instead of hard resetting the board on any tx error, just signal error
    and let the main loop reinitialize communication
    with this, hot-plugging the mouse does work already
    [marble_fx.ino]
2023-02-26 add heartbeat to detect mouse disconnect in stream mode
    Poll the mouse every 30 seconds even in stream mode, so that e.g. mouse
    unplug / replug gets detected reliably.
    Use the existing timer implementation for that, rename it to MyTimer.
2023-02-26 switch to stream mode by default
2023-02-28 compile.sh: allow disable CDC serial port
    this can be tried in case of compatibility problems, but beware: you
    will no longer be able to reprogram without pushing the reset button.
2026-02-21 wrap heartbeat LED into a class
    This will flash every two seconds, and turn solid on if the jiggler
    timed out or is disabled.
2026-02-21 allow dynamically disabling of the jiggler
    Press red (scroll) and middle button together, to disable jiggler until
    next movement.
    To achieve this, the jiggle timer is just expired immediately.
2026-03-05 make SERIALDEBUG usable with windows host
    Apparently closing the serial port on windows makes Serial.print() block
    and thus enabling SERIALDEBUG breaks mouse operations after the serial
    port is closed. Work around this issue by wrapping all Serial calls to
    check if Serial is actually available.
    Note: the simpler "if (Serial) {...}" did not work, as this includes a
    "delay(10)" for every call...
2026-03-07 add acceleration also to the scroll wheel emulation
