seife/marble_fx/(notices)

Notices in the files:
marble_fx.ino:
To Public License, Version 2, as published by Sam Hocevar. See
http://www.wtfpl.net/ for more details.
